twotwoship/fpga_microwave/README.md

# fpga_microwave
See microwave_no_video.pptx for explanations.

# operation video  youtube link
https://youtu.be/djOuPST5QnM
